cheehieu/rc-car-collision/images/aerial_view.jpg

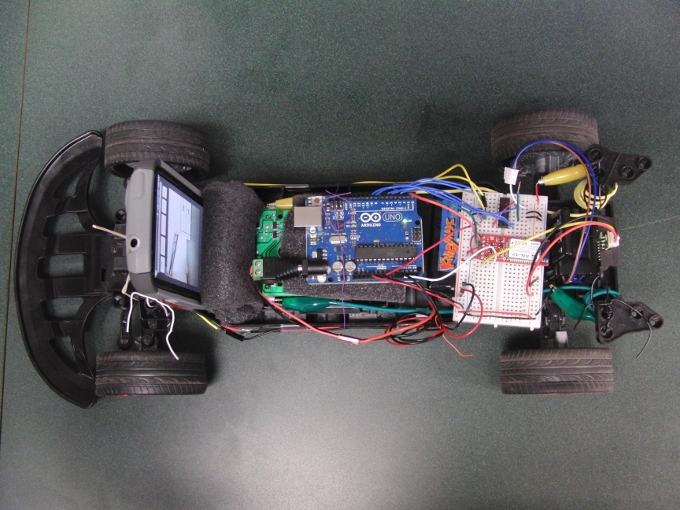
images/aerial_view.jpg
