cheehieu/rc-car-collision/images/CIMG1522.JPG

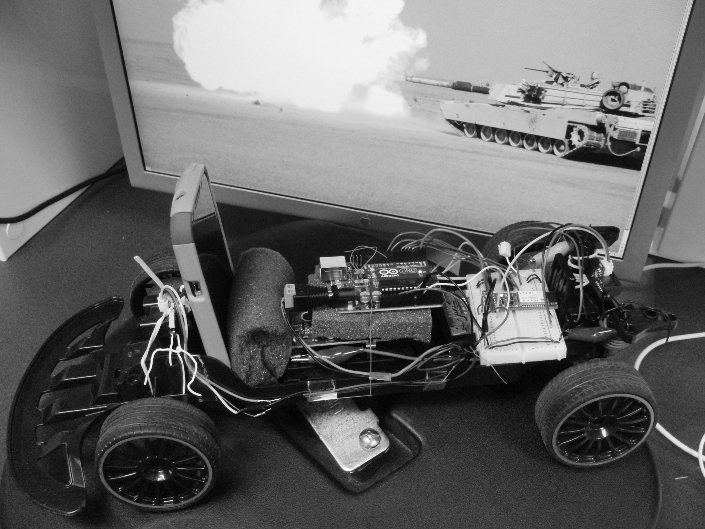
images/CIMG1522.JPG
