cheehieu/rc-car-collision/images/CIMG1516.JPG

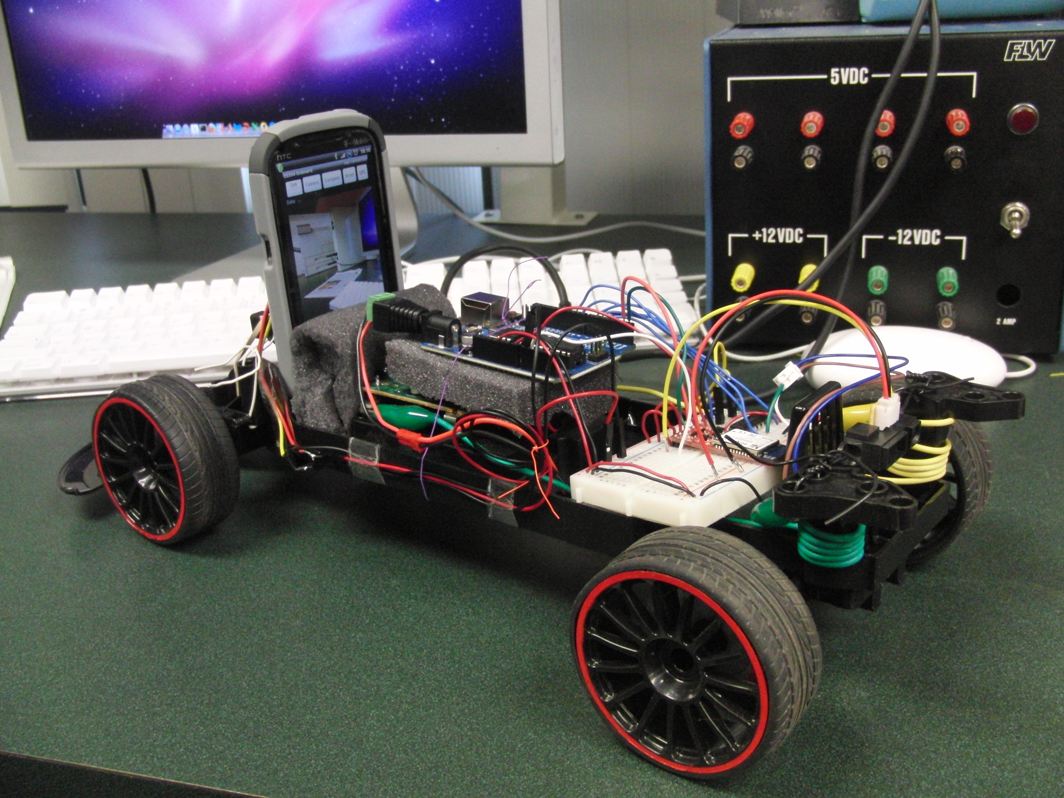
images/CIMG1516.JPG
