cheehieu/rc-car-collision/images/CIMG1518.JPG

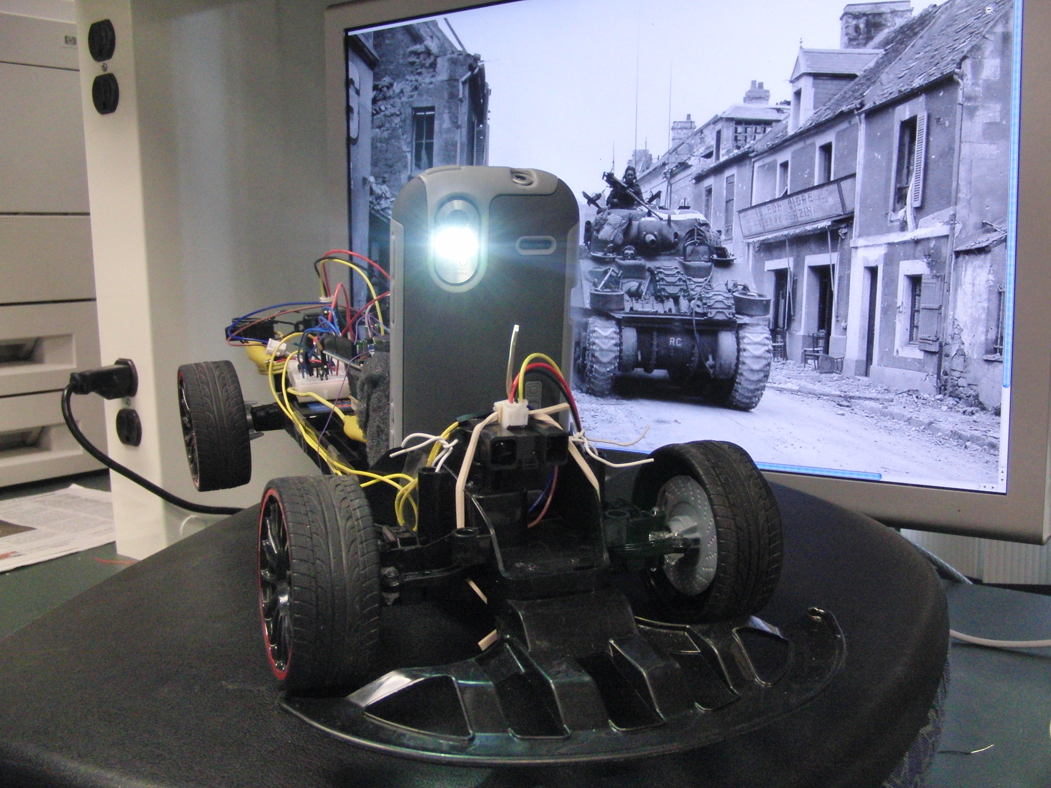
images/CIMG1518.JPG
