cheehieu/rc-car-collision/images/CIMG1519.JPG

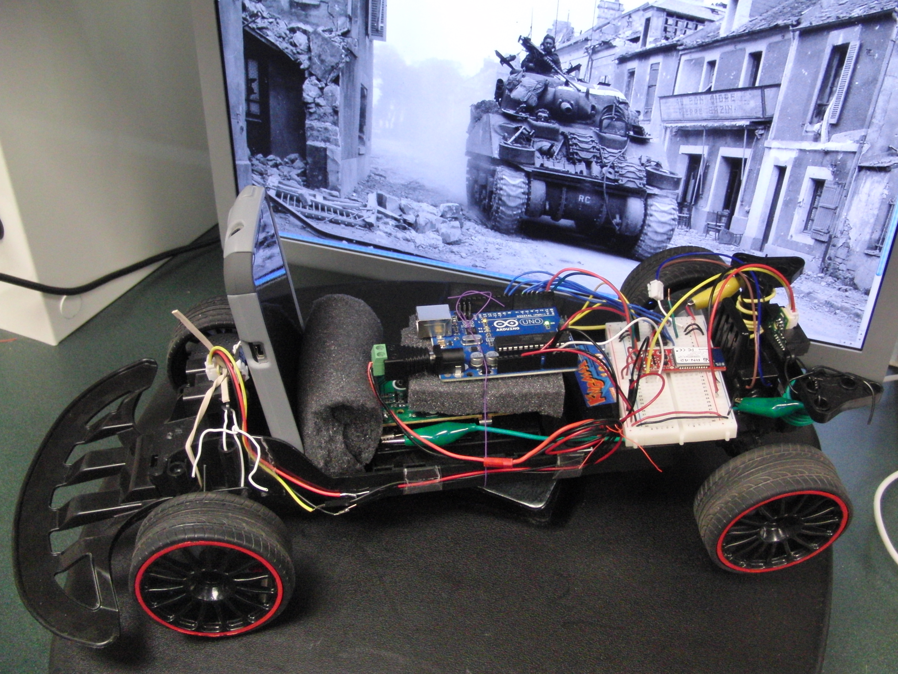
images/CIMG1519.JPG
