cheehieu/rc-car-collision/images/CIMG1520.JPG

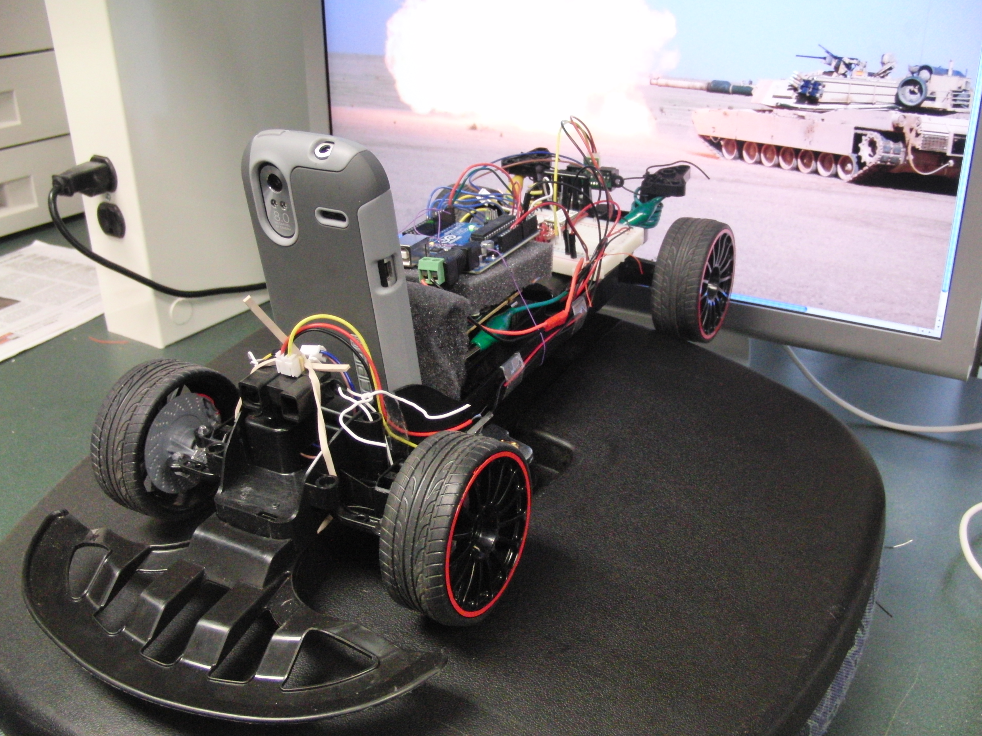
images/CIMG1520.JPG
