cheehieu/rc-car-collision/images/CIMG1521.JPG

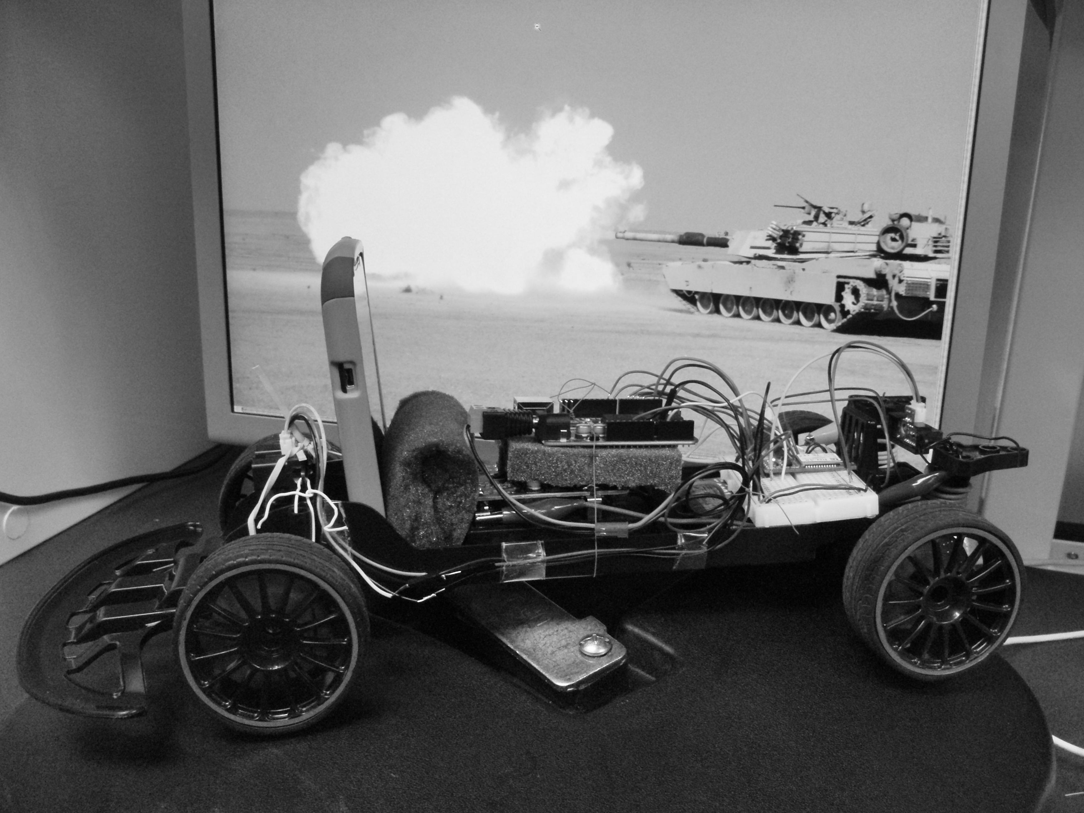
images/CIMG1521.JPG
