cheehieu/rc-car-collision/images/CIMG1523.JPG

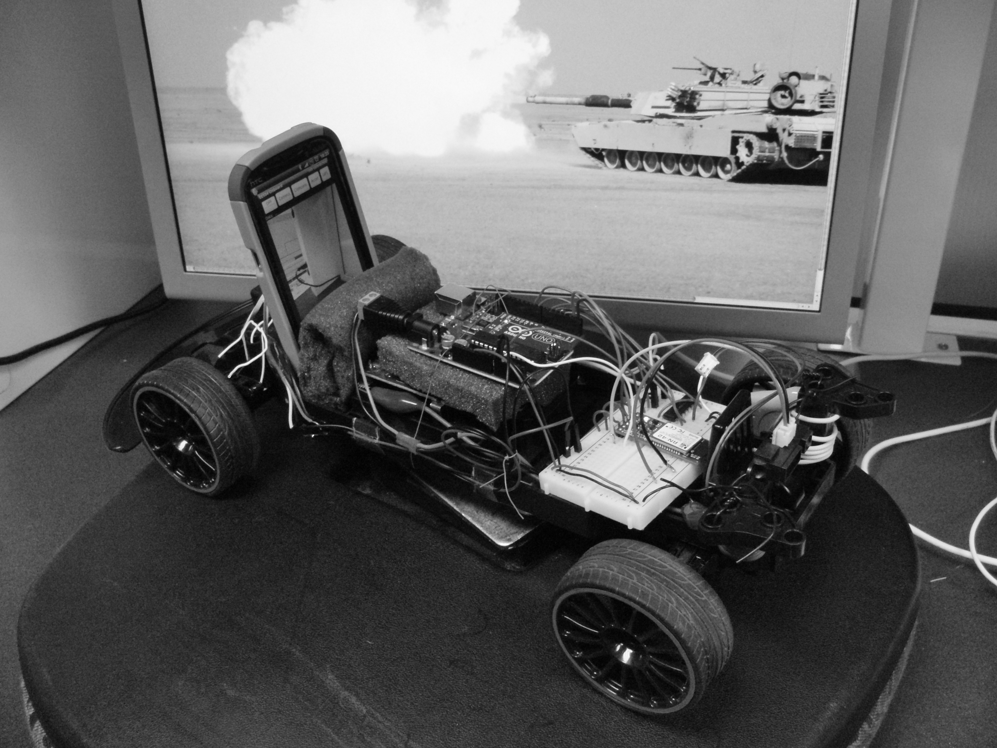
images/CIMG1523.JPG
