cheehieu/rc-car-collision/images/controller_app.png

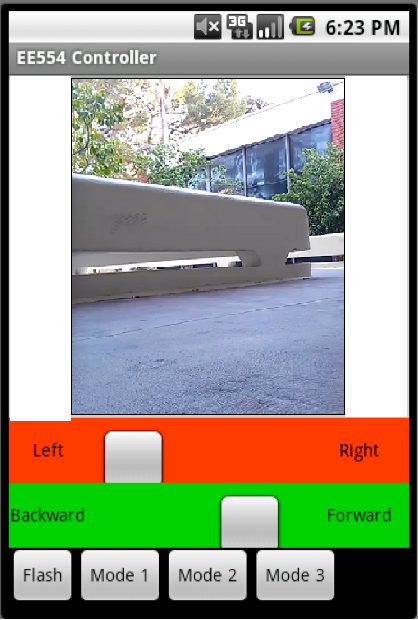
images/controller_app.png
