cheehieu/rc-car-collision/images/EE554ProjectProposal.png

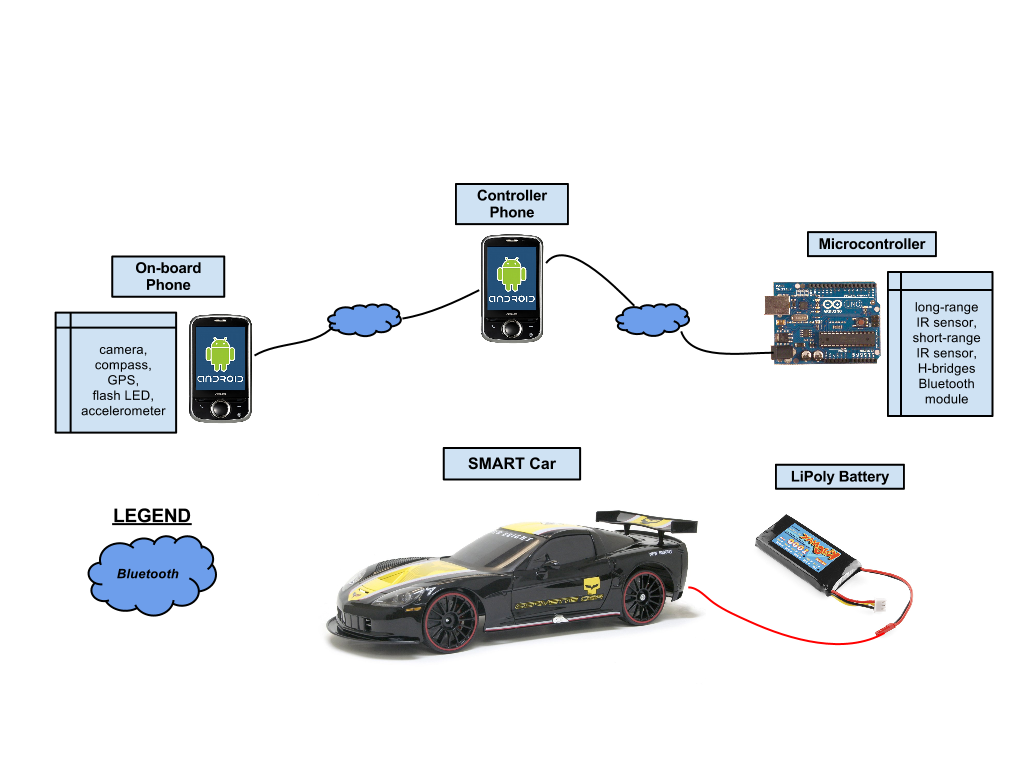
images/EE554ProjectProposal.png
