cheehieu/rc-car-collision/images/onboard_app.png

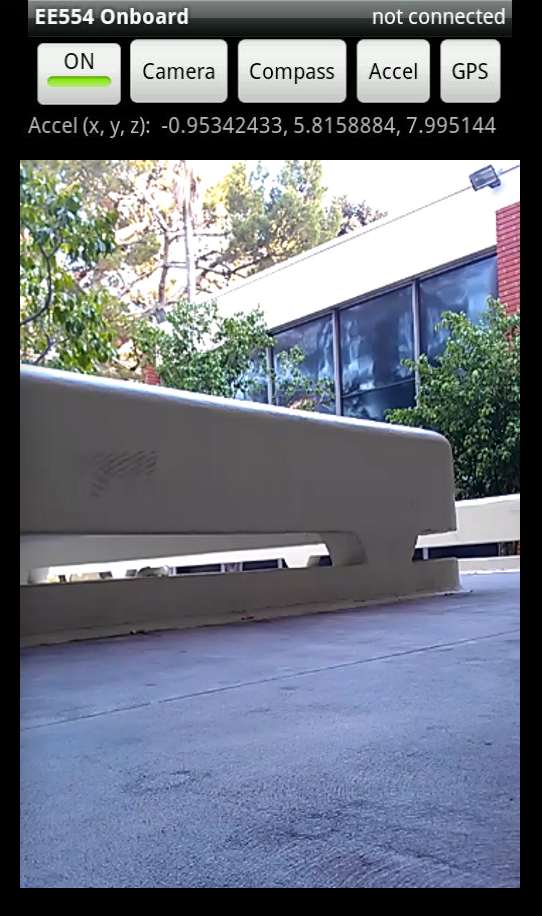
images/onboard_app.png
