cheehieu/rc-car-collision/images/Smart_Car_diagram.png

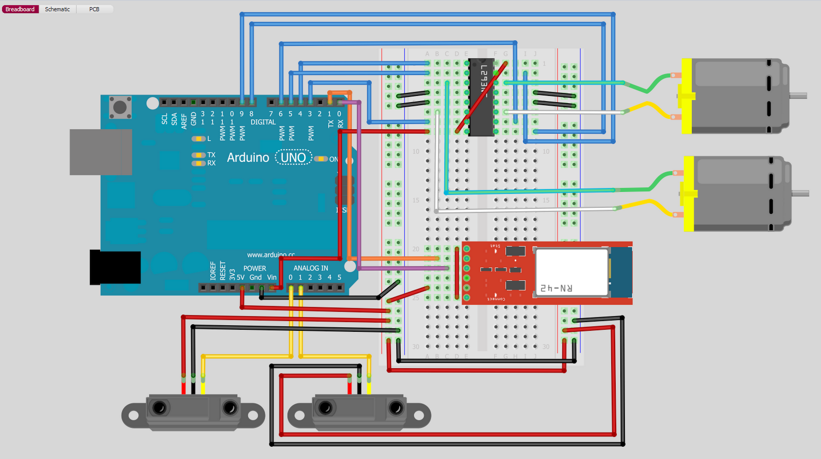
images/Smart_Car_diagram.png
