cheehieu/rc-car-collision/(commit log)

2014-11-13 Added Arduino sensor and motor control software.
2014-11-16 Added camera images.
